makerust/Freude/Hardware/Pictures/PrototypeFitment/ISO_2.jpg

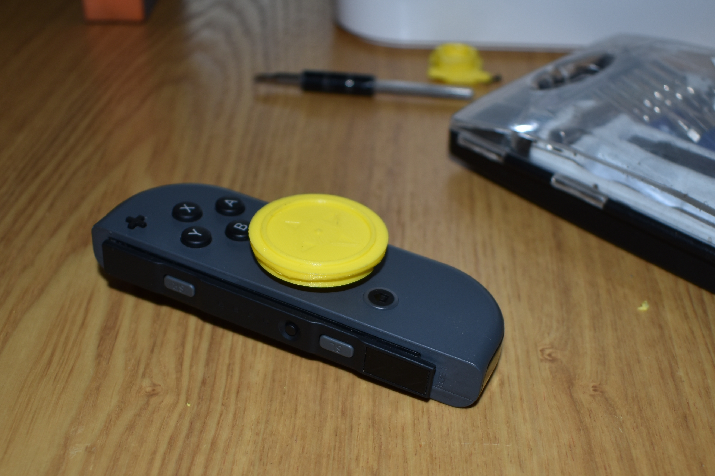
Hardware/Pictures/PrototypeFitment/ISO_2.jpg
