makerust/Freude/Hardware/Pictures/PrototypeFitment/Top.jpg

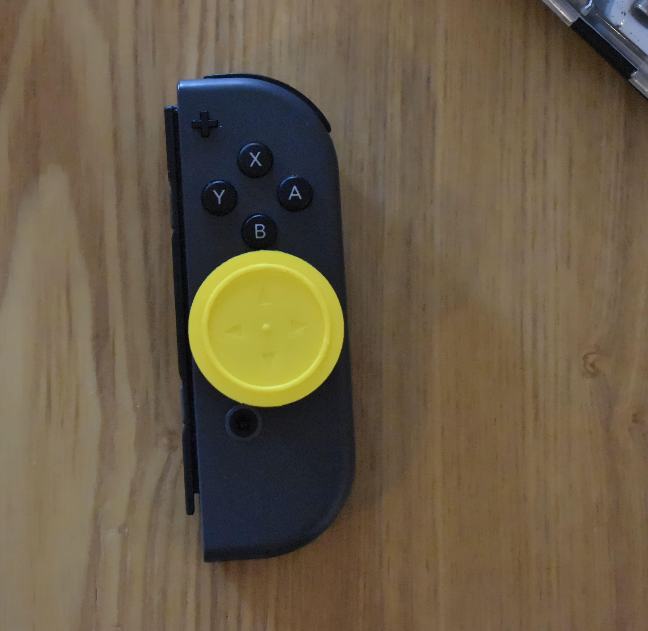
Hardware/Pictures/PrototypeFitment/Top.jpg
