makerust/Freude/Hardware/Pictures/PrototypeFitment/ISO_1.jpg

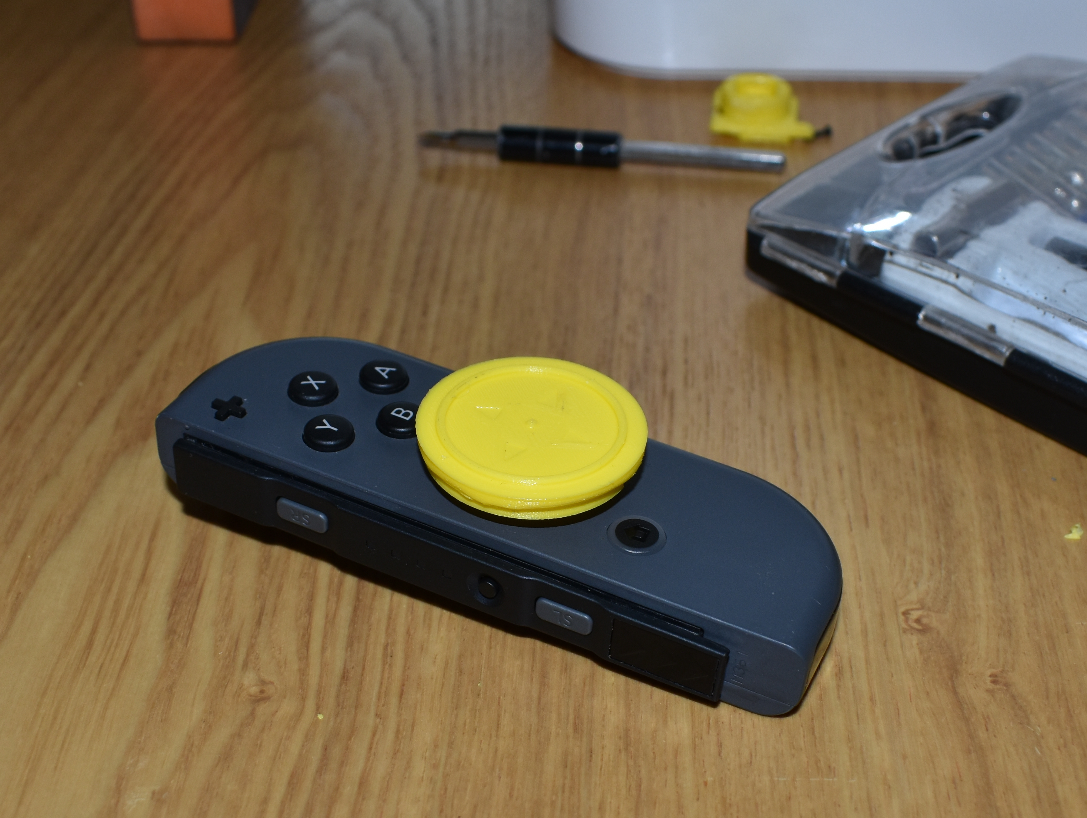
Hardware/Pictures/PrototypeFitment/ISO_1.jpg
