makerust/Freude/Hardware/Pictures/PrototypeFitment/Side.jpg

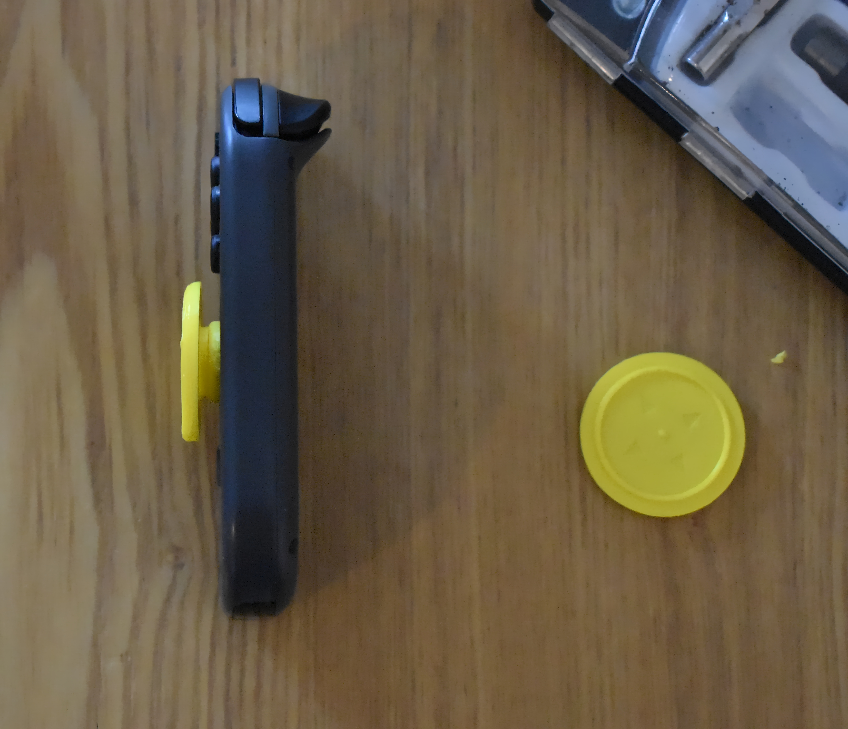
Hardware/Pictures/PrototypeFitment/Side.jpg
