makerust/Freude/Hardware/Freude_Housings/Freude.FCStd

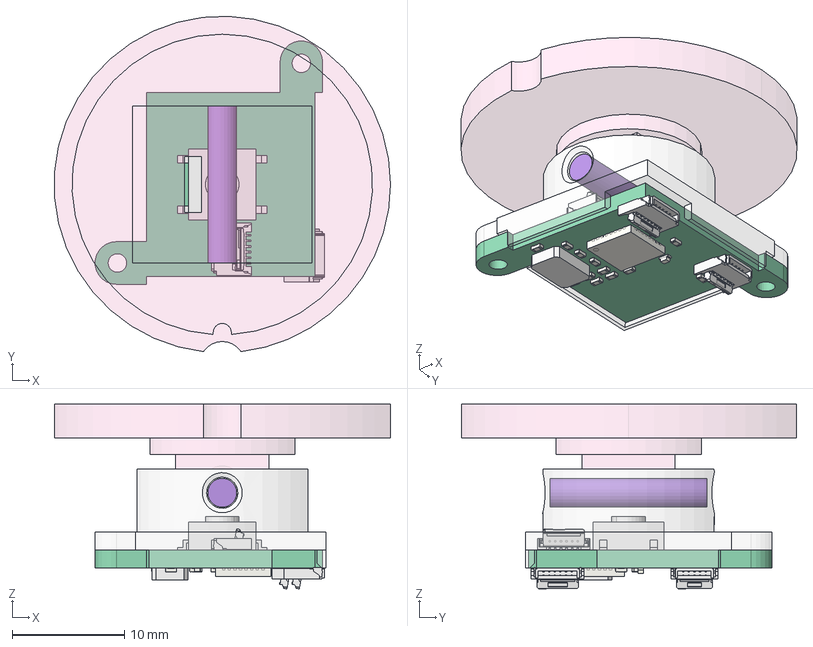
[picture p5: CAD file, 2020-09-07]
Hardware/Freude_Housings/Freude.FCStd
30.0 x 29.9 x 16.5 mm
Pcb_57ef
Y1_Crystal_SMD_5032_5F37B9DD
C8_R_0402_1005Metric_5F2C5172
C12_R_0402_1005Metric_5F2C4FBF
C15_R_0402_1005Metric_5F2C54B4
R3_R_0402_1005Metric_5F2C5424
L1_R_0402_1005Metric_5F2C5295
C7_R_0402_1005Metric_5F2C52C5
R4_R_0402_1005Metric_5F2C5454
C9_R_0402_1005Metric_5F2C51E4
R6_R_0402_1005Metric_5F2C5484
C10_R_0402_1005Metric_5F2C50D9
C6_R_0402_1005Metric_5F2C52F5
C11_R_0402_1005Metric_5F2C50A9
J4_5034800600_5F37B28E
D1_LED_0402_1005Metric_5F2C5218
J2_1_5F2C51A8[2]
U2_QFN-32-1EP_5x5mm_Pitch0.5mm_5F2C501D
J3_5034800600_5F2C4F09[2]
SW1_B3FS_1000_5F2C4F48[2]
Top_Housing
Pin001
