makerust/Freude/Hardware/Freude_Touchpad/Freude_Touchpad.step

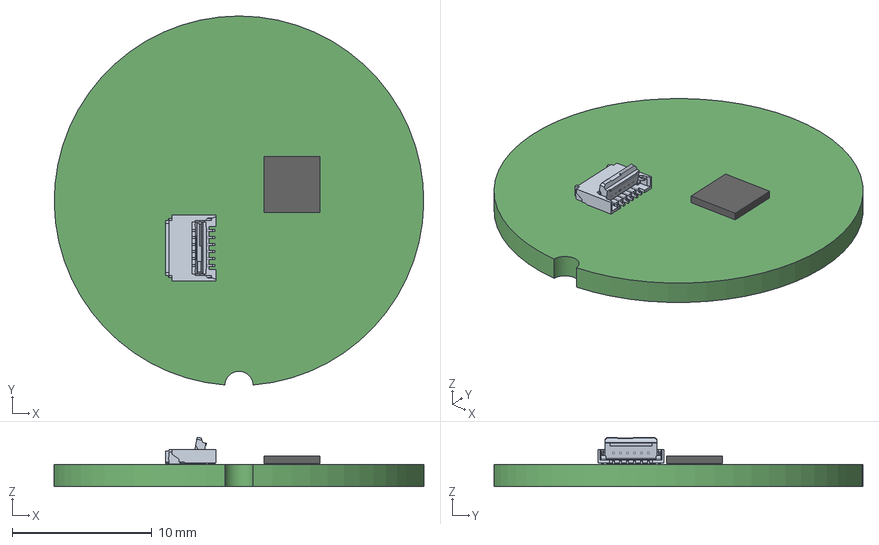
[picture p6: CAD file, 2020-08-08]
Hardware/Freude_Touchpad/Freude_Touchpad.step
26.4 x 26.4 x 3.53 mm
R_0402 x 14
