makerust/Freude/Hardware/Freude_Touchpad/Freude_Touchpad.kicad_pcb

## KiCad design Hardware/Freude_Touchpad/Freude_Touchpad.kicad_pcb (2020-11-27)

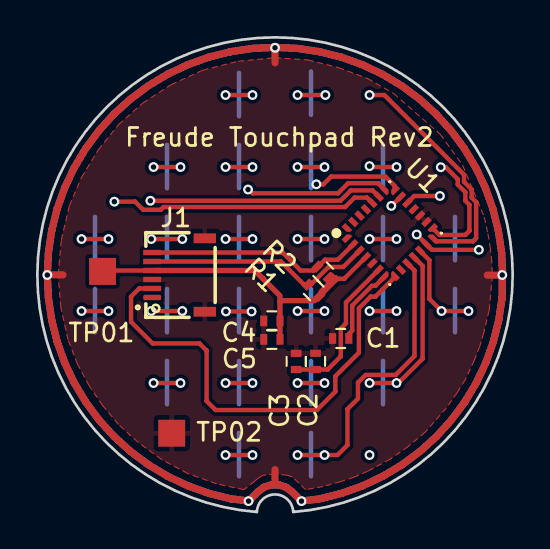
[picture p7: board Freude_Touchpad.kicad_pcb from above]

Board: 2 copper layers, 26.4 x 26.4 mm, 11 parts (0 on the bottom side), 7 nets.

Parts:
C1: C_Small; R_0402
C2, C4: 100pF; R_0402
C3, C5: 1uF; R_0402
J1: Conn_01x06_Female; 503480-0600
R1, R2: 4.7k; R_0402
TP01, TP02: Measurement_Point_Square-SMD-Pad_Small
U1: IQS572

Connections:
+3.3VA: C4.2, C5.2, J1.4, R1.1, R2.1, TP01.1, U1.4
/NRST: C1.1, U1.7
/RDY_TP: J1.2, U1.8
/SCL_TP: J1.5, R1.2, U1.3
/SDA_TP: J1.6, R2.2, U1.2
GNDA: C1.2, C2.1, C3.1, C4.1, C5.1, J1.0, J1.3, TP02.1, U1.5, U1.16, U1.17
unnamed: C2.2, C3.2, U1.6
