makerust/Freude/Hardware/Freude_BreakoutBoard/Freude_BreakoutBoard.kicad_pcb

## KiCad design Hardware/Freude_BreakoutBoard/Freude_BreakoutBoard.kicad_pcb (2020-11-27)

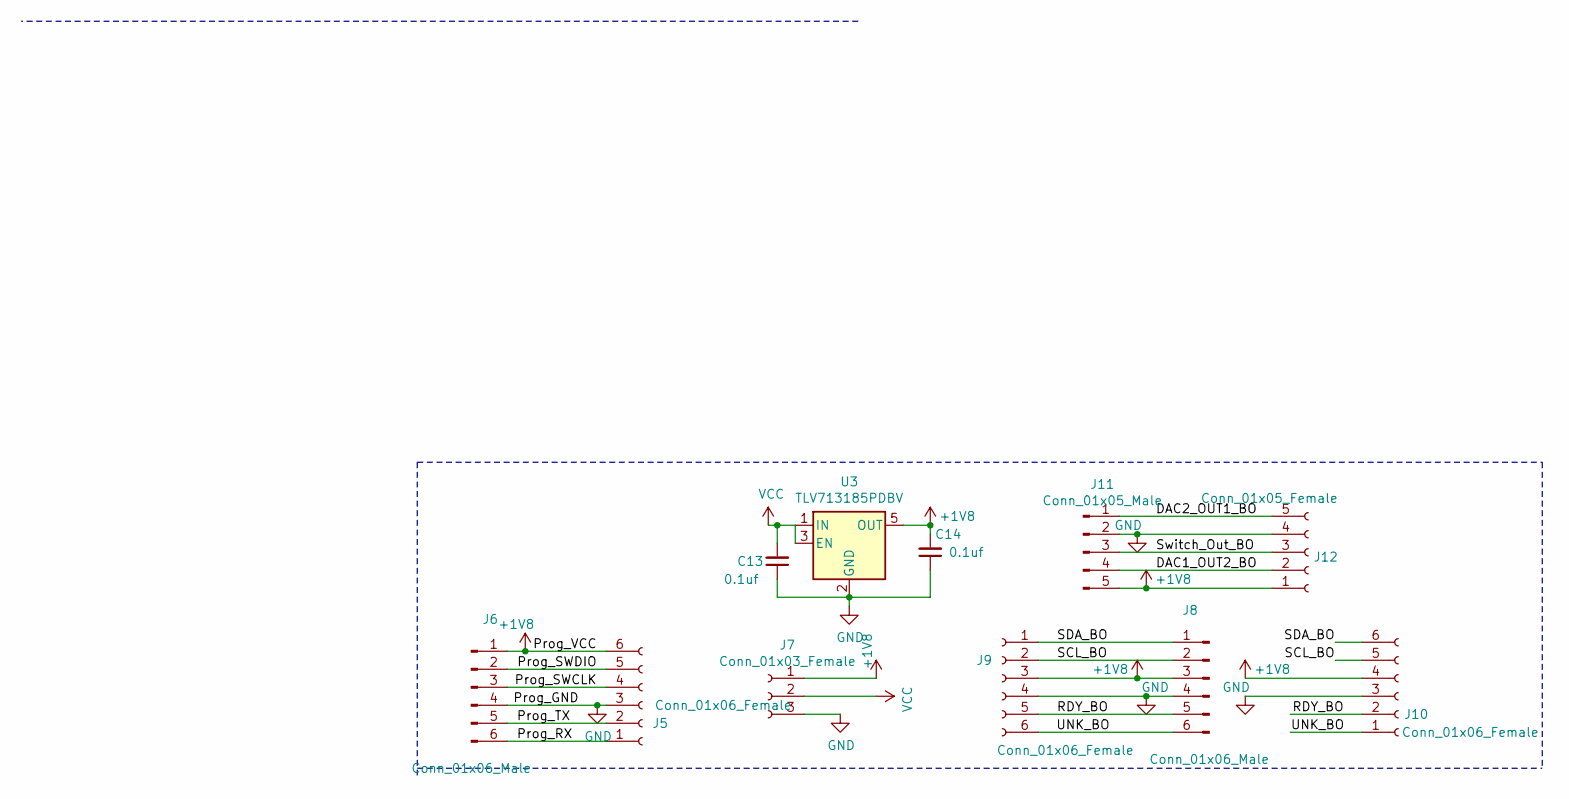
[picture p8: schematic Freude_BreakoutBoard.sch]

Parts:
C13, C14: 0.1uf; R_0603
J5, J9, J10: Conn_01x06_Female; 503480-0600
J6, J8: Conn_01x06_Male; 1X06-KIT
J7: Conn_01x03_Female; 1X03
J11: Conn_01x05_Male; 1X05
J12: Conn_01x05_Female; 503480-0500
U3: TLV713185PDBV; SOT-23-5

Connections:
+1V8: C14.2, J5.6, J6.1, J7.1, J8.3, J9.3, J10.4, J11.5, J12.1, U3.5 (OUT)
/DAC1_OUT2_BO: J11.4, J12.2
/DAC2_OUT1_BO: J11.1, J12.5
/Prog_RX: J5.1, J6.6
/Prog_SWCLK: J5.4, J6.3
/Prog_SWDIO: J5.5, J6.2
/Prog_TX: J5.2, J6.5
/RDY_BO: J8.5, J9.5, J10.2
/SCL_BO: J8.2, J9.2, J10.5
/SDA_BO: J8.1, J9.1, J10.6
/Switch_Out_BO: J11.3, J12.3
/UNK_BO: J8.6, J9.6, J10.1
GND: C13.1, C14.1, J5.3, J6.4, J7.3, J8.4, J9.4, J10.3, J11.2, J12.4, U3.2 (GND)
VCC: C13.2, J7.2, U3.1 (IN), U3.3 (EN)

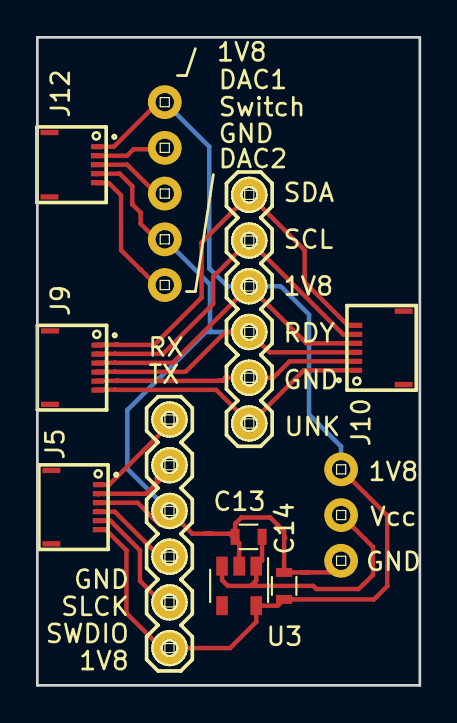
[picture p9: board Freude_BreakoutBoard.kicad_pcb from above]

Board: 2 copper layers, 21.2 x 36.0 mm, 11 parts (0 on the bottom side), 14 nets.
