makerust/Freude/Hardware/Freude_Microcontroller/Freude_Microcontroller.kicad_pcb

## KiCad design Hardware/Freude_Microcontroller/Freude_Microcontroller.kicad_pcb (2020-09-07)

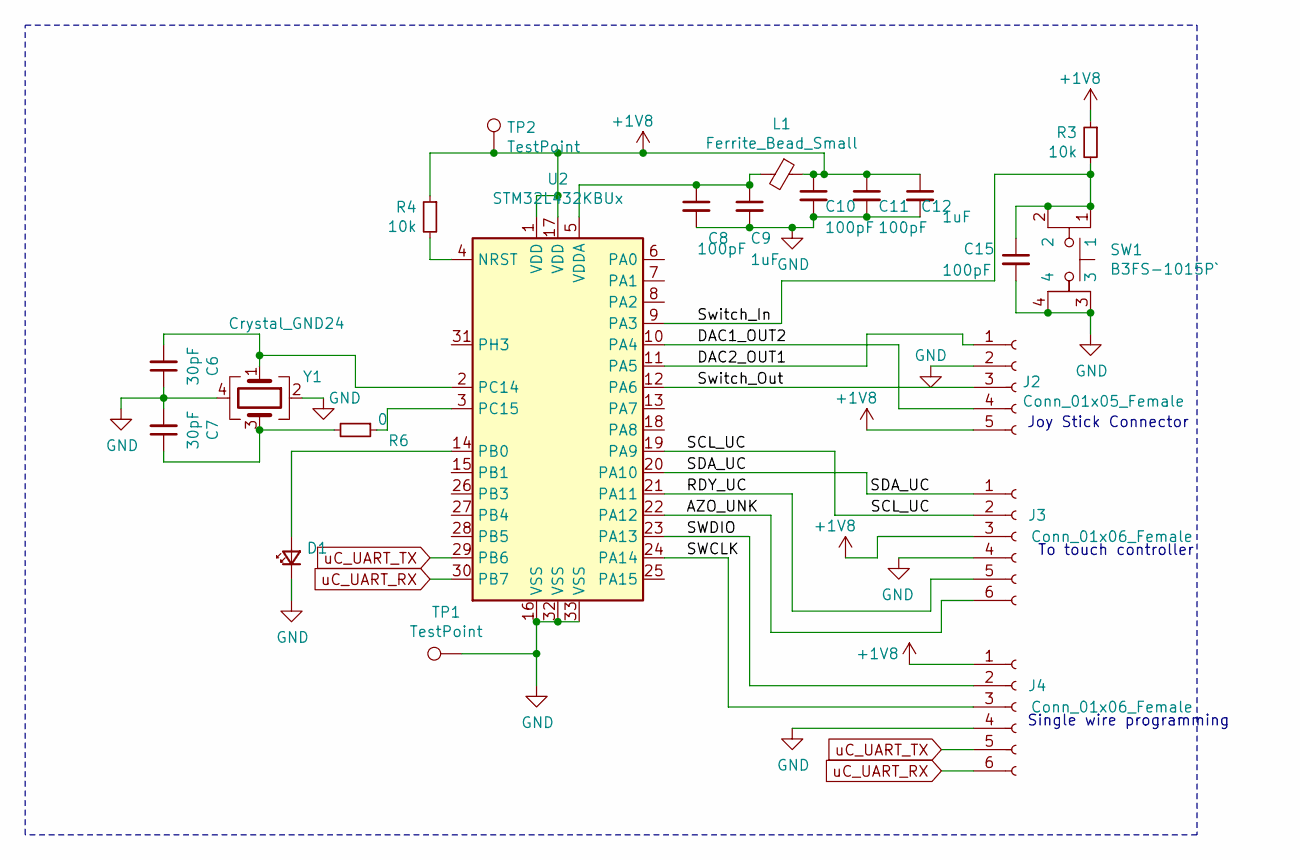
[picture p10: schematic Freude_Microcontroller.sch]

Parts:
C6, C7: 30pF; R_0402
C8, C10, C11, C15: 100pF; R_0402
C9, C12: 1uF; R_0402
D1: 16-213/GHC-YR1S1/3T; LED_0402
J2: Conn_01x05_Female; 503480-0500
J3, J4: Conn_01x06_Female; 503480-0600
L1: Ferrite_Bead_Small; R_0402
R3, R4: 10k; R_0402
R6: 0; R_0402
SW1: B3FS-1015P`; B3FS-1015P
TP1, TP2: TestPoint; Measurement_Point_Square-SMD-Pad_Small
U2: STM32L432KBUx; QFN-32-1EP_5x5mm_P0.5mm_EP3.45x3.45mm
Y1: Crystal_GND24; Crystal_SMD_5032-4pin_5.0x3.2mm; MFG Partnumber ABM3B-8.000MHZ-B2-T

Connections:
+1V8: C10.1, C11.1, C12.1, J2.5, J3.3, J4.1, L1.1, R3.1, R4.1, TP2.1, U2.1 (VDD), U2.17 (VDD)
/AZO_UNK: J3.6, U2.22 (PA12)
/DAC1_OUT2: J2.4, U2.10 (PA4)
/DAC2_OUT1: J2.1, U2.11 (PA5)
/RDY_UC: J3.5, U2.21 (PA11)
/SCL_UC: J3.2, U2.19 (PA9)
/SDA_UC: J3.1, U2.20 (PA10)
/SWCLK: J4.3, U2.24 (PA14)
/SWDIO: J4.2, U2.23 (PA13)
/Switch_In: C15.1, R3.2, SW1.1, SW1.2, U2.9 (PA3)
/Switch_Out: J2.3, U2.12 (PA6)
GND: C6.1, C7.2, C8.2, C9.2, C10.2, C11.2, C12.2, C15.2, D1.1 (K), J2.2, J3.4, J4.4, SW1.3, SW1.4, TP1.1, U2.16 (VSS), U2.32 (VSS), U2.33 (VSS), Y1.2, Y1.4
unnamed: C6.2, U2.2 (PC14), Y1.1
unnamed: C7.1, R6.2, Y1.3
unnamed: C8.1, C9.1, L1.2, U2.5 (VDDA)
unnamed: D1.2 (A), U2.14 (PB0)
unnamed: R4.2, U2.4 (NRST)
unnamed: R6.1, U2.3 (PC15)
uC_UART_RX: J4.6, U2.30 (PB7)
uC_UART_TX: J4.5, U2.29 (PB6)

Notes on the sheet:
Joy Stick Connector
To touch controller
Single wire programming

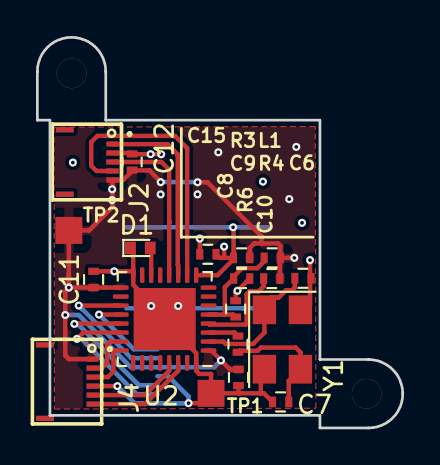
[picture p11: board Freude_Microcontroller.kicad_pcb from above]

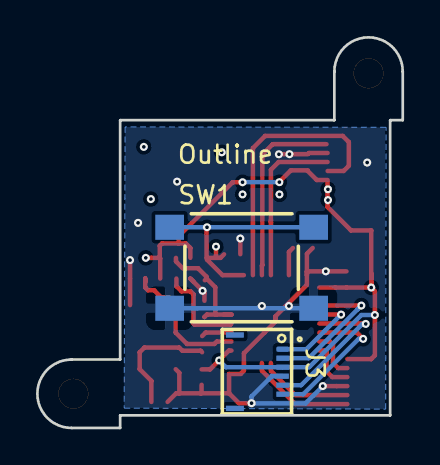
[picture p12: board Freude_Microcontroller.kicad_pcb from below]

Board: 4 copper layers, 20.3 x 21.7 mm, 22 parts (3 on the bottom side), 20 nets.

Other parts of the board:
Outline: Joystick Envelope
