makerust/Freude/Hardware/DEPRICATED_Full_PCBs/Freude.kicad_pcb

## KiCad design Hardware/DEPRICATED_Full_PCBs/Freude.kicad_pcb (2020-08-08)

Schematic: Freude.sch

Parts:
C1: C_Small; R_0402
C2, C4, C8, C10, C11, C15: 100pF; R_0402
C3, C5, C9, C12: 1uF; R_0402
C6, C7: 30pF; R_0402
C13, C14: 0.1uf; R_0603
D1: 16-213/GHC-YR1S1/3T; LED_0402
J1, J3, J4, J5, J9, J10: Conn_01x06_Female; 503480-0600
J2, J12: Conn_01x05_Female; 503480-0500
J6, J8: Conn_01x06_Male; 1X06-KIT
J7: Conn_01x03_Female; 1X03
J11: Conn_01x05_Male; 1X05
L1: Ferrite_Bead_Small; R_0402
R1, R2: 4.7k; R_0402
R3, R4: 10k; R_0402
R6: 0; R_0402
SW1: B3FS-1015P`; B3FS-1015P
TP1, TP2: TestPoint; Measurement_Point_Square-SMD-Pad_Small
U1: IQS572
U2: STM32L432KBUx; QFN-32-1EP_5x5mm_P0.5mm_EP3.45x3.45mm
U3: TLV713185PDBV; SOT-23-5
X1: Custom_Touchpad; Touchpad
Y1: Crystal_GND24; Crystal_SMD_5032-4pin_5.0x3.2mm; MFG Partnumber ABM3B-8.000MHZ-B2-T

Connections:
+1V8: C4.2, C5.2, C10.1, C11.1, C12.1, C14.2, J1.3, J2.5, J3.3, J4.1, J5.1, J6.1, J7.1, J8.3, J9.3, J10.3, J11.5, J12.5, L1.1, R1.1, R2.1, R3.1, R4.1, TP2.1, U1.4, U2.1, U2.17, U3.5 (OUT)
/AZO_UNK: J3.6, U2.22
/DAC1_OUT2: J2.4, U2.10
/DAC1_OUT2_BO: J11.4, J12.4
/DAC2_OUT1: J2.1, U2.11
/DAC2_OUT1_BO: J11.1, J12.1
/PGM: U1.27
/Prog_RX: J5.6, J6.6
/Prog_SWCLK: J5.3, J6.3
/Prog_SWDIO: J5.2, J6.2
/Prog_TX: J5.5, J6.5
/RDY_BO: J8.4, J9.4, J10.4
/RDY_TP: J1.5, U1.8
/RDY_UC: J3.5, U2.21
/SCL_BO: J8.2, J9.2, J10.2
/SCL_TP: J1.2, R1.2, U1.3
/SCL_UC: J3.2, U2.19
/SDA_BO: J8.1, J9.1, J10.1
/SDA_TP: J1.1, R2.2, U1.2
/SDA_UC: J3.1, U2.20
/SWCLK: J4.3, U2.24
/SWDIO: J4.2, U2.23
/SW_IN: U1.28
/Switch_In: C15.1, R3.2, SW1.1, SW1.2, U2.9
/Switch_Out: J2.3, U2.12
/Switch_Out_BO: J11.3, J12.3
/UNK_BO: J8.6, J9.6, J10.6
GND: C1.2, C2.1, C3.1, C4.1, C5.1, C6.1, C7.2, C8.2, C9.2, C10.2, C11.2, C12.2, C13.1, C14.1, C15.2, D1.1, J1.4, J2.2, J3.4, J4.4, J5.4, J6.4, J7.3, J8.5, J9.5, J10.5, J11.2, J12.2, SW1.3, SW1.4, TP1.1, U1.5, U2.16, U2.32, U2.33, U3.2 (GND), Y1.2, Y1.4
unnamed: C2.2, C3.2, U1.6
unnamed: C6.2, U2.2, Y1.1
unnamed: C7.1, R6.2, Y1.3
unnamed: C8.1, C9.1, L1.2, U2.5
unnamed: D1.2, U2.14
unnamed: R4.2, U2.4
unnamed: R6.1, U2.3
VCC: C13.2, J7.2, U3.1 (IN), U3.3 (EN)
XA00: U1.18, X1.XA00
XA01: U1.19, X1.XA01
XA02: U1.20, X1.XA02
XA03: U1.21, X1.XA03
XA04: U1.22, X1.XA04
XA05: U1.23, X1.XA05
XA06: U1.24, X1.XA06
YA00: U1.10, X1.YA00
YA01: U1.11, X1.YA01
YA02: U1.12, X1.YA02
YA03: U1.13, X1.YA03
YA04: U1.14, X1.YA04
YA05: U1.15, X1.YA05
uC_UART_RX: J4.6, U2.30
uC_UART_TX: J4.5, U2.29

Notes on the sheet:
Joy Stick Connector
To touch controller
Single wire programming

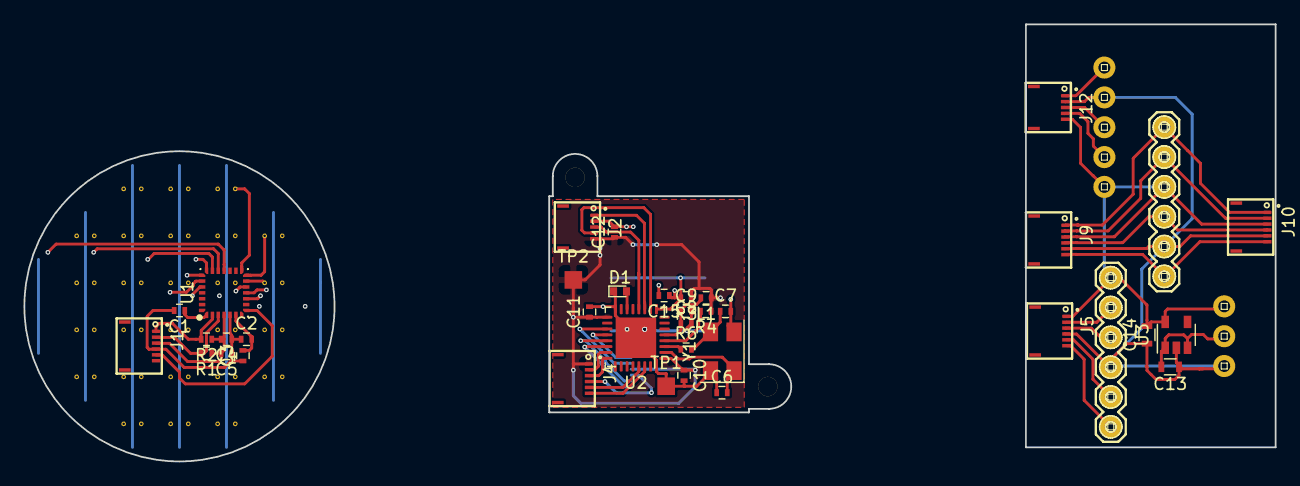
[picture p13: board Freude.kicad_pcb from above]

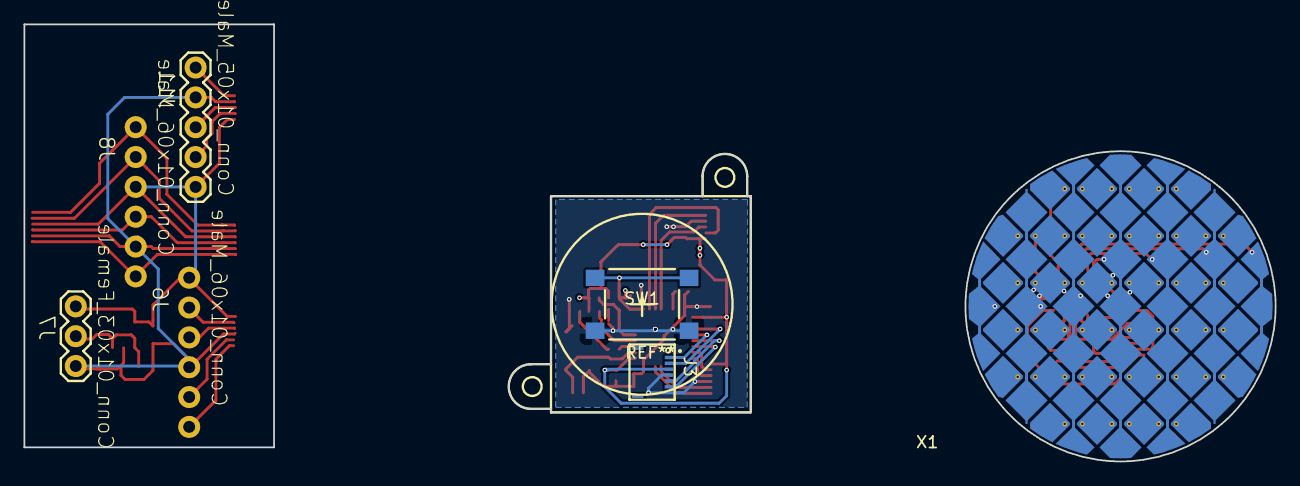
[picture p14: board Freude.kicad_pcb from below]

Board: 4 copper layers, 106.5 x 37.2 mm, 42 parts (3 on the bottom side), 49 nets.
