makerust/Freude/(threads)

Thread 1 (2020-08-30):

Replace Retention feature with simpler feature

makerust, 2020-08-30:
Remove complaint retention from Housing Top, and mating feature from Housing Bottom with a retention feature that uses an oval slot in Housing Top and adds a hole for a peg the size of normal FDM filament to the bottom housing. Constraint in 2 directions is not necessary because Assy is already constrained from turning.

Closed 2020-09-07.

Thread 5 (2020-09-20):

Correct J8, J9 and J10 pinout in Breakout board schematic and PCB file (RDY & GND)

makerust, 2020-09-20:

Closed 2020-11-27.

Thread 6 (2020-09-20):

Correct ZIF on all boards, cable induces mirroring

makerust, 2020-09-20:

Closed 2020-11-27.
