makerust/Freude/Software/Software.ioc

Mcu.UserName=STM32L432KBUx
PA10.Signal=I2C1_SDA
PA11.Signal=GPXTI11
PA3.Signal=GPXTI3
PA4.Signal=COMP_DAC11_group
PA5.Signal=COMP_DAC12_group
PA6.Signal=GPIO_Output
PA9.Signal=I2C1_SCL
PB0.Signal=GPIO_Output
PB6.Signal=USART1_TX
PB7.Signal=USART1_RX
PH3-BOOT0.GPIO_Label=TestName
PH3-BOOT0.Signal=GPIO_Output
