makerust/Freude/(commit log)

2020-05-23 inital commit
    [Freude.kicad_pcb, Freude.sch]
2020-05-27 added a 7x8 diamond touch sensor as a sketch
    [Freude.kicad_pcb]
2020-06-11 azoteq IQS562 as new touch controller
    [Freude.kicad_pcb, Freude.sch]
2020-06-11 Add Hardware dir, move HW files
    [Freude.kicad_pcb, Freude.sch]
2020-07-20 Add uc, inter connects, futter to schematic
    [Freude.kicad_pcb, Freude.sch]
2020-07-21 add jtag lines
    [Freude.sch]
2020-07-21 add UART
2020-07-22 change debug header to 9 pin for uart, add 5 pin connector to con
    [Freude.sch]
2020-07-22 added 5 pin connector, added envelope for uc board, changed uc to low power smaller footprint after seeing envelope
    [Freude.kicad_pcb, Freude.sch]
2020-07-22 change uc for smaller footprint, lower input voltage.
2020-07-23 add connectors, symbol for touch pad, start placement of touch controller
    [Freude.kicad_pcb, Freude.sch]
2020-07-25 Route touchpad complete *airhorn*, add switch schematic, add domain boxes schematic
    [Freude.kicad_pcb, Freude.sch]
2020-07-25 fix several power connection errors on U2 -power and ground, perhaps- added 6-pin connector to touch pad to match brain board after rejecting 180 deg connector
    [Freude.kicad_pcb, Freude.sch]
2020-07-26 add detail to joystick envelope, changed sides of connectors to better fit joystick, reroute in progress
    [Freude.kicad_pcb]
2020-07-26 add custom 3d part for IQS572
    [Freude.kicad_pcb]
2020-07-26 create part B3FS-1015p include 3d file. Add to PCB
    [Freude.kicad_pcb]
2020-07-26 define boards edges
    [Freude.kicad_pcb]
2020-07-27 added connectors for debug board.
    [Freude.kicad_pcb, Freude.sch]
2020-07-28 add led, change sw1 footprint, add testpads
    [Freude.kicad_pcb, Freude.sch]
2020-07-28 rearrange and rerout
    [Freude.kicad_pcb, Freude.sch]
2020-07-29 rerouted, tidied
    [Freude.kicad_pcb]
2020-07-29 routing on boards finished. Will change to 3 board projects for 3d reasons. Considering branch
    [Freude.FCStd, Freude.kicad_pcb]
2020-07-29 finished routing. consider branch, will split project into 3 boards to make 3d assy possible
2020-08-05 Creat one project director just for the touchpad PCB, remade the touchpad part as pours to avoid via shorts
    [Freude_Touchpad.kicad_pcb, Freude_Touchpad.sch]
2020-08-08 broke PCB file into 3 folders and 3 PCB projects for each of the PCBAs, to make 3D drafting simpler. Created 3D housing project.
    [Freude.FCStd, Freude.kicad_pcb, Freude.sch, Freude_BreakoutBoard.kicad_pcb, Freude_BreakoutBoard.sch, Freude_Microcontroller.kicad_pcb, Freude_Microcontroller.sch, Freude_Touchpad.kicad_pcb]
2020-08-08 remove depricated file
    [Freude.FCStd]
2020-08-08 remove further depricated files
    [Freude.kicad_pcb, Freude.sch]
2020-08-11 Bottom housing near finish. Mating pockets added, cut out for conn refined, critical edges chamfered or fileted.
    [Freude.FCStd]
2020-08-15 made outline smaller to fit housing, subsequent rerouting
    [Freude_Microcontroller.kicad_pcb]
2020-08-16 add stem and flange to top housing
    [Freude.FCStd]
2020-08-18 Changed location of connector to make routing of cable easier
    [Freude_Touchpad.kicad_pcb]
2020-08-18 Finished top housing, added cap part, release candidate
    [Freude.FCStd]
2020-08-30 add photos of prototype housings fitment
2020-08-30 add prototype release output files
    [Freude_BreakoutBoard-B_CrtYd.gbr, Freude_BreakoutBoard-B_Cu.gbr, Freude_BreakoutBoard-B_Mask.gbr, Freude_BreakoutBoard-B_Paste.gbr, Freude_BreakoutBoard-B_SilkS.gbr, Freude_BreakoutBoard-Edge_Cuts.gbr, Freude_BreakoutBoard-F_CrtYd.gbr, Freude_BreakoutBoard-F_Cu.gbr]
2020-08-30 remove inner layers
    [Freude_BreakoutBoard.kicad_pcb]
2020-08-30 silk layout, proto release candidate
    [Freude_Microcontroller.kicad_pcb]
2020-08-30 prototype cadidate
    [Freude.FCStd]
2020-09-01 change hole size to 0.45mm, decrease soldermask expansion
    [Freude_Microcontroller.kicad_pcb, Freude_Touchpad.kicad_pcb]
2020-09-03 add silk to breakout :|
    [Freude_BreakoutBoard.kicad_pcb]
2020-09-07 Closes #1, replaces compliant retention mechanism with pin
    [Freude.FCStd]
2020-09-07 resolves #2, resolves #3
    [Freude_BreakoutBoard.kicad_pcb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]
2020-09-20 Debug branch first commit
    [Freude Debug (1).cfg, Freude Debug.cfg]
2020-09-24 revised functions, does not build but it's late
    [Freude Debug (1).cfg, Freude Debug.cfg, New_configuration (2).cfg, New_configuration (3).cfg, Software Debug.cfg]
2020-09-27 lots of changes from Alex Shirley, I2C not finished but better
    [New_configuration (2).cfg, New_configuration (3).cfg, Software Debug.cfg]
2020-10-03 untested schedulerer
    [New_configuration.cfg, Software Debug.cfg]
2020-11-18 added ground pour and ground ring
    [Freude_Touchpad.kicad_pcb, Freude_Touchpad.sch]
2020-11-27 resolves 10, resolves 9, resolves 6, resolves 5, add ground ring around touch sensor, add ground ring on top, separate RX from TX and include ground plane between
    [Freude_BreakoutBoard.kicad_pcb, Freude_BreakoutBoard.sch, Freude_Touchpad.kicad_pcb, Freude_Touchpad.sch]
2020-11-27 resolves #10, resolves #9, resolves #6, resolves #5, add ground ring around touch sensor, add ground ring on top, separate RX from TX and include ground plane between
    [Freude_BreakoutBoard.kicad_pcb, Freude_BreakoutBoard.sch, Freude_Touchpad.kicad_pcb, Freude_Touchpad.sch]
