makerust/Freude/(notices)

Notices in the files:
Software/Src/main.c:
COPYRIGHT(c) 2020 STMicroelectronics
(C) COPYRIGHT STMicroelectronics *****END OF FILE
